gbhug5a/Microwave_Anti-Beep_Mod/Pictures/Controller board wiring.jpg

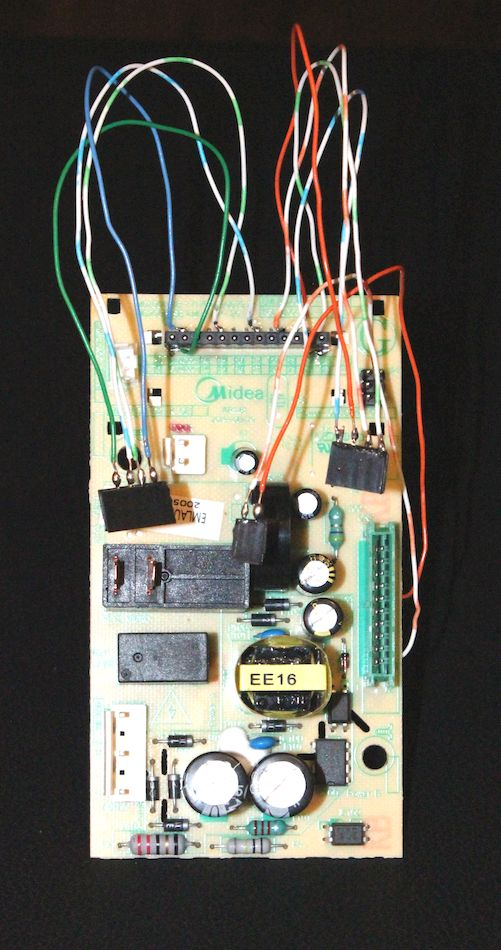
Pictures/Controller board wiring.jpg
