gbhug5a/Microwave_Anti-Beep_Mod/Pictures/Completed board.jpg

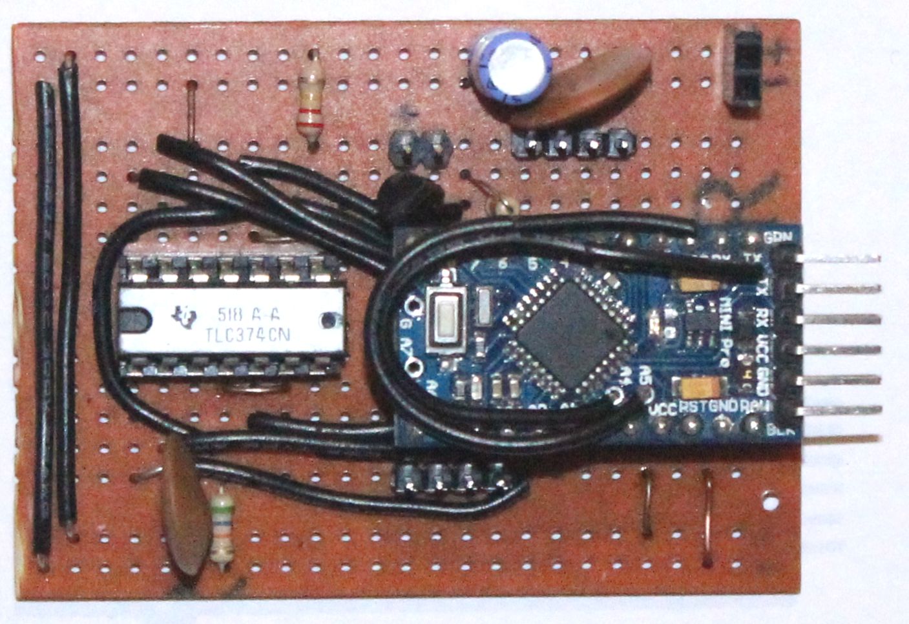
Pictures/Completed board.jpg
