gbhug5a/Microwave_Anti-Beep_Mod/Pictures/Connected board.jpg

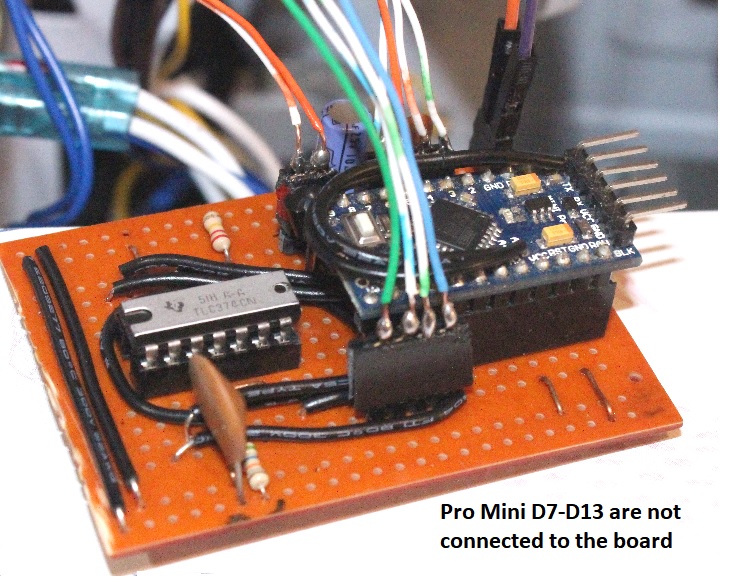
Pictures/Connected board.jpg
