gbhug5a/Microwave_Anti-Beep_Mod/Pictures/Display connections.jpg

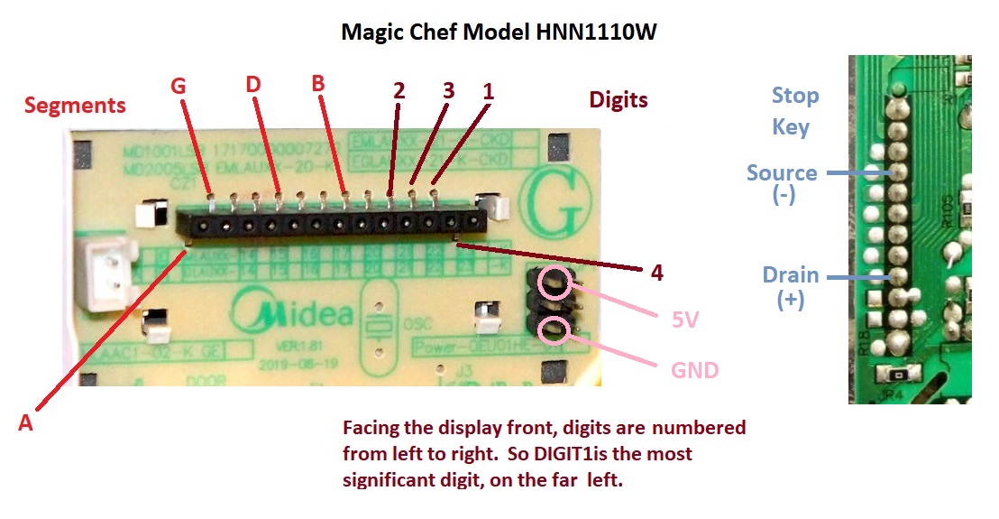
Pictures/Display connections.jpg
