gbhug5a/Microwave_Anti-Beep_Mod/Schematic.jpg

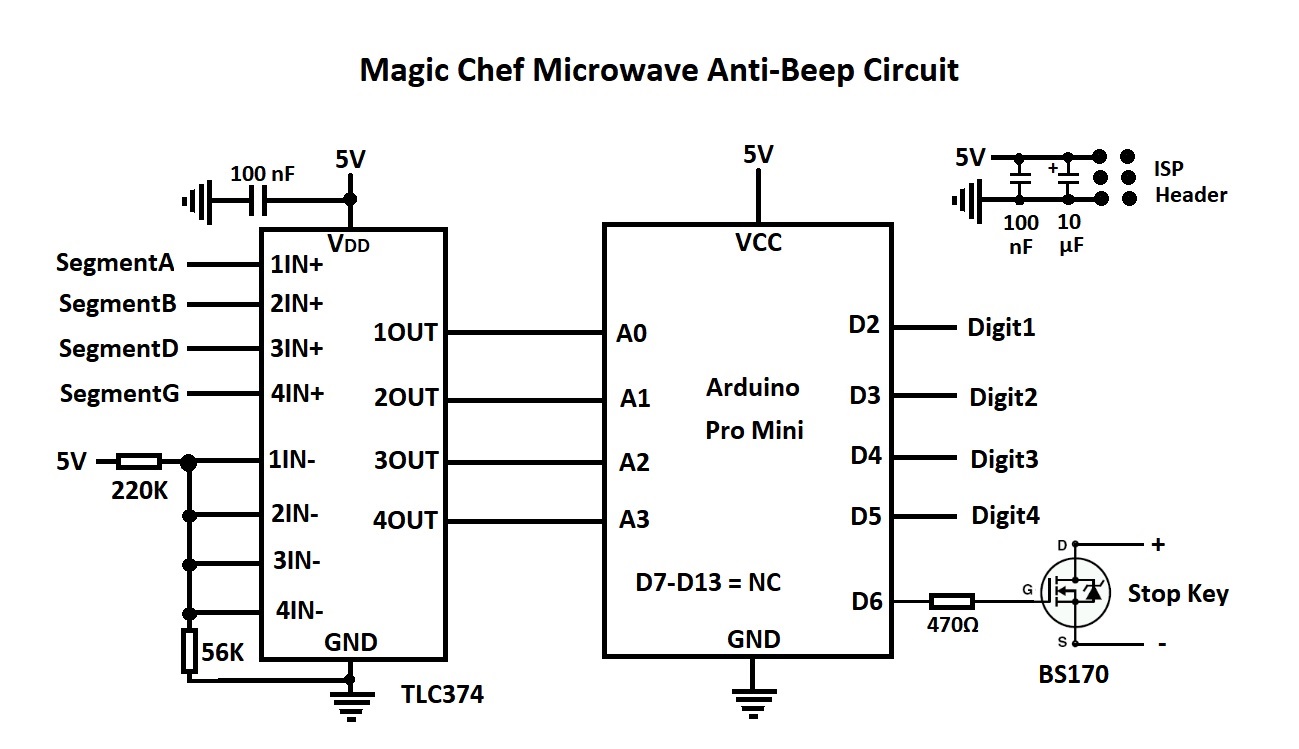
Schematic.jpg
